Sargunjit5915/Drone-CM5-Carrier/Circular_RPi5.kicad_pcb

## KiCad design Circular_RPi5.kicad_pcb (2026-08-14)

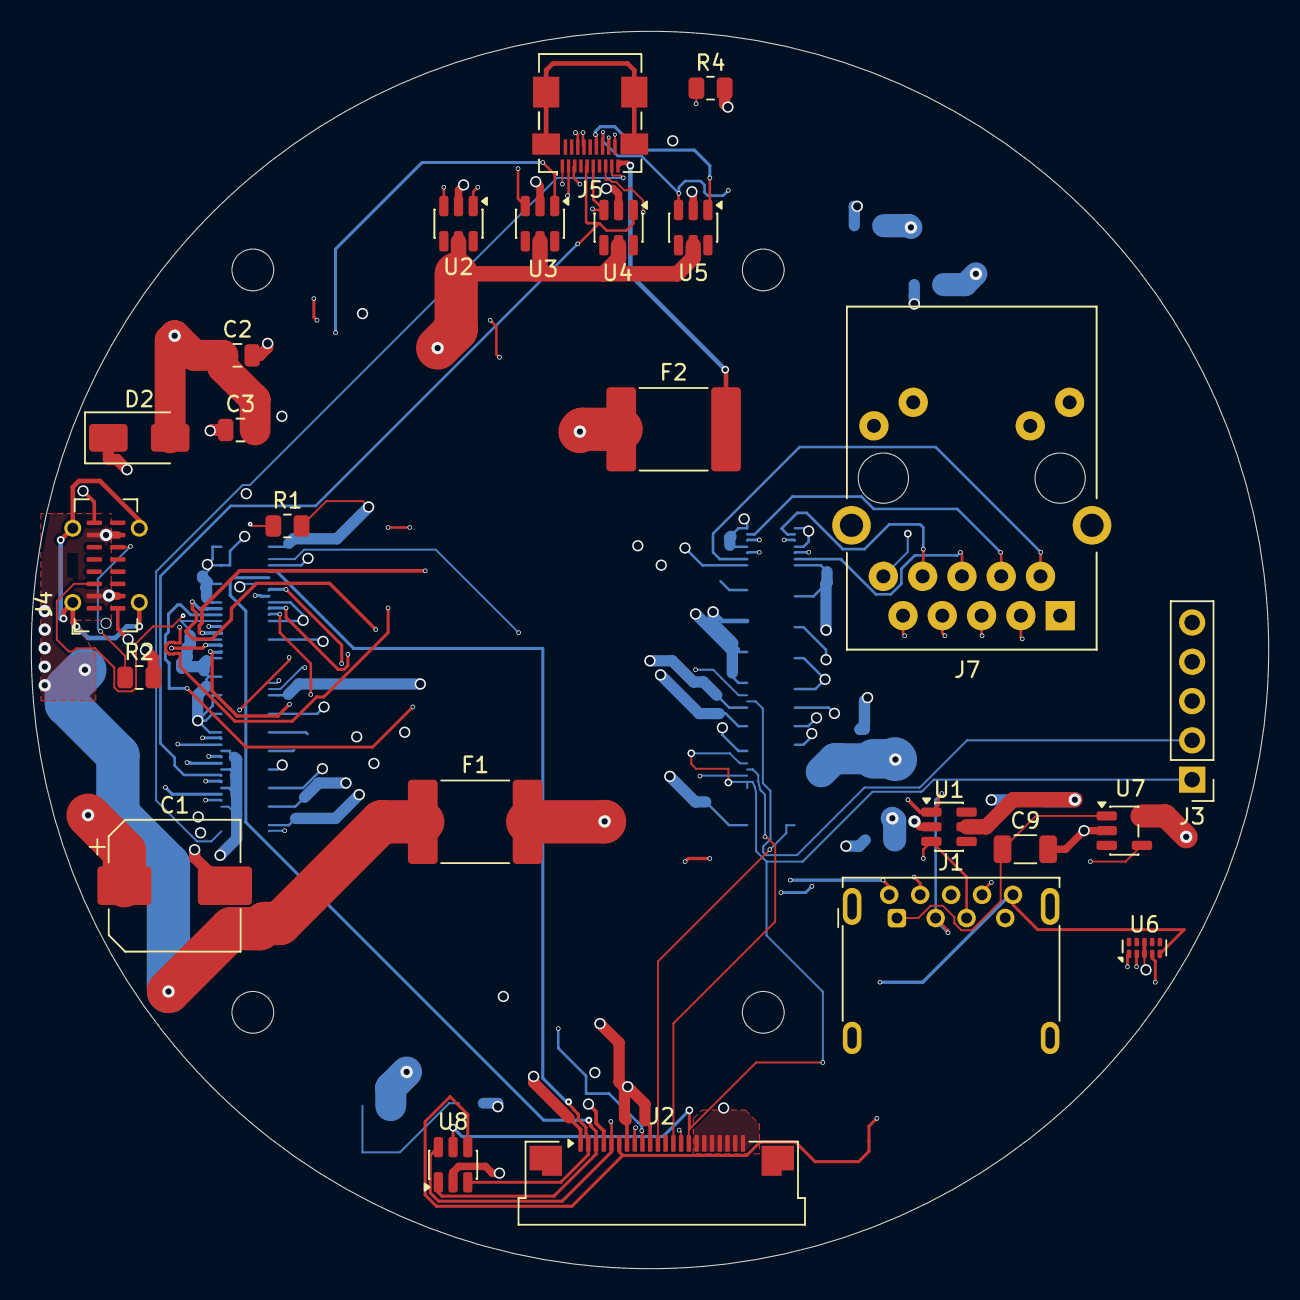
[picture p1: board Circular_RPi5.kicad_pcb from above]

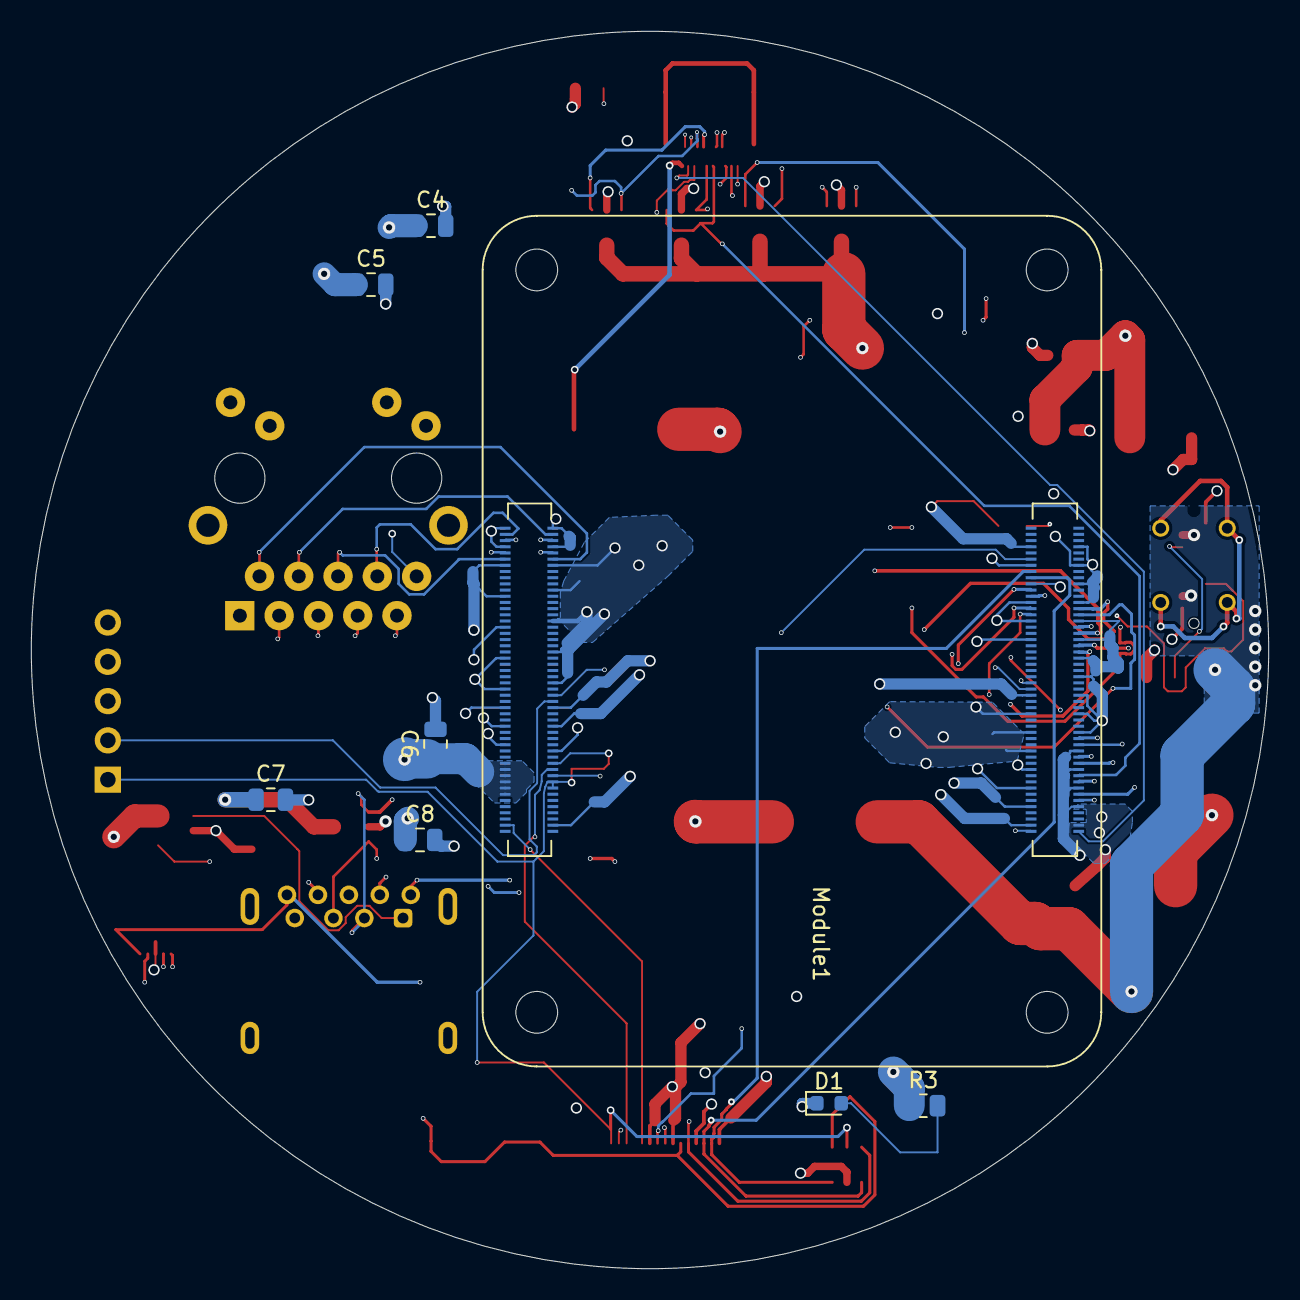
[picture p2: board Circular_RPi5.kicad_pcb from below]

Board: 6 copper layers, 80.0 x 80.0 mm, 32 parts (8 on the bottom side), 47 nets.

Parts:
C1: 470uF; CP_Elec_8x10
C2: 10uF; C_0805_2012Metric
C3, C4, C5, C6, C7, C8: 0.1uF; C_0805_2012Metric
C9: 22uF; C_1206_3216Metric
D1: LED; LED_0603_1608Metric
D2: D_TVS; D_SMA
F1, F2: 2920L500/16MR; Fuse_2920_7451Metric
J1: USB3_A; USB3_A_Molex_48393-001
J2: Conn_01x22; Amphenol_F32Q-1A7x1-11022_1x22-1MP_P0.5mm_Horizontal
J3: GPIO Pins; PinHeader_1x05_P2.54mm_Vertical
J4: USB_C; USB_C_Receptacle_G-Switch_GT-USB-7051x
J5: HDMI_D_1.4; HDMI_Micro-D_Molex_46765-0xxx
J7: RJ45_RB1-125B8G1A; RJ45_UDE_RB1-125B8G1A
Module1: ComputeModule5-CM5; Raspberry-Pi-5-Compute-Module
R1, R2: 5.1k; R_0805_2012Metric
R3: 330 ohm; R_0805_2012Metric
R4: 47k ohm; R_0805_2012Metric
U1, U2, U3, U4, U5, U8: USBLC; SOT-23-6
U6: TPD; USON-10_2.5x1.0mm_P0.5mm
U7: TPS; SOT-23-5

Connections:
+5V: C1.1, C2.1, C3.2, C4.1, C5.1, C6.1, C7.1, C8.1, D2.2 (A2), F1.2, F2.1, J3.5, Module1.77 (+5v_(Input)), Module1.79 (+5v_(Input)), Module1.81 (+5v_(Input)), Module1.83 (+5v_(Input)), Module1.85 (+5v_(Input)), Module1.87 (+5v_(Input)), R3.1, U1.5 (VBUS), U2.5 (VBUS), U3.5 (VBUS), U4.5 (VBUS), U5.5 (VBUS), U7.5 (IN)
/+3.3V: J2.15, J3.1, Module1.78 (GPIO_VREF(1.8v/3.3v_Input)), Module1.84 (+3.3v_(Output)), Module1.86 (+3.3v_(Output)), U8.5 (VBUS)
/CAM_GPIO0: J2.11, Module1.97 (CAM_GPIO0)
/Ethernet_Pair0_N: J7.R3, Module1.10 (Ethernet_Pair0_N)
/Ethernet_Pair0_P: J7.R2, Module1.12 (Ethernet_Pair0_P)
/Ethernet_Pair1_N: J7.R5, Module1.6 (Ethernet_Pair1_N)
/Ethernet_Pair1_P: J7.R4, Module1.4 (Ethernet_Pair1_P)
/Ethernet_Pair2_N: J7.R7, Module1.9 (Ethernet_Pair2_N)
/Ethernet_Pair2_P: J7.R6, Module1.11 (Ethernet_Pair2_P)
/Ethernet_Pair3_N: J7.R9, Module1.5 (Ethernet_Pair3_N)
/Ethernet_Pair3_P: J7.R8, Module1.3 (Ethernet_Pair3_P)
/GPIO2: J3.2, Module1.58 (GPIO2)
/GPIO3: J3.3, Module1.56 (GPIO3)
/HDMI0_CEC: J5.15 (CEC), Module1.151 (HDMI0_CEC)
/HDMI0_CLK_N: J5.14 (CK-), Module1.190 (HDMI0_CLK_N), U5.3 (I/O2)
/HDMI0_CLK_P: J5.12 (CK+), Module1.188 (HDMI0_CLK_P), U5.1 (I/O1)
/HDMI0_HOTPLUG: J5.1 (HPD/HEAC-), Module1.153 (HDMI0_HOTPLUG), R4.1
/HDMI0_SCL: J5.17 (SCL), Module1.200 (HDMI0_SCL)
/HDMI0_SDA: J5.18 (SDA), Module1.199 (HDMI0_SDA)
/HDMI0_TX0_N: J5.11 (D0-), Module1.184 (HDMI0_TX0_N), U4.3 (I/O2)
/HDMI0_TX0_P: J5.9 (D0+), Module1.182 (HDMI0_TX0_P), U4.1 (I/O1)
/HDMI0_TX1_N: J5.8 (D1-), Module1.178 (HDMI0_TX1_N), U3.3 (I/O2)
/HDMI0_TX1_P: J5.6 (D1+), Module1.176 (HDMI0_TX1_P), U3.1 (I/O1)
/HDMI0_TX2_N: J5.5 (D2-), Module1.172 (HDMI0_TX2_N), U2.3 (I/O2)
/HDMI0_TX2_P: J5.3 (D2+), Module1.170 (HDMI0_TX2_P), U2.1 (I/O1)
/MIPI0_C_N: J2.8, Module1.127 (MIPI0_C_N)
/MIPI0_C_P: J2.9, Module1.129 (MIPI0_C_P)
/MIPI0_D0_N: J2.2, Module1.115 (MIPI0_D0_N), U8.3 (I/O2)
/MIPI0_D0_P: J2.3, Module1.117 (MIPI0_D0_P), U8.1 (I/O1)
/MIPI0_D1_N: J2.5, Module1.121 (MIPI0_D1_N), U8.6 (I/O4)
/MIPI0_D1_P: J2.6, Module1.123 (MIPI0_D1_P), U8.4 (I/O3)
/SCL0: J2.13, Module1.80 (SCL0)
/SDA0: J2.14, Module1.82 (SDA0)
/SSRX+: J1.6, Module1.130 (USB3-0-RX_P), U6.4 (D2+)
/SSRX-: J1.5, Module1.128 (USB3-0-RX_N), U6.5 (D2-)
/SSTX+: J1.9, Module1.142 (USB3-0-TX_P), U6.1 (D1+)
/SSTX-: J1.8, Module1.140 (USB3-0-TX_N), U6.2 (D1-)
/USB3-0-D_N: J1.2, Module1.136 (USB3-0-D_N), U1.1 (I/O1)
/USB3-0-D_P: J1.3, Module1.134 (USB3-0-D_P), U1.3 (I/O2)
/VBUS_EN: Module1.111 (VBUS_EN), U7.4 (EN)
/VBUS_IN: F1.1, J4.A4, J4.A9 (VBUS), J4.B4, J4.B9 (VBUS)
GND: C1.2, C2.2, C3.1, C4.2, C5.2, C6.2, C7.2, C8.2, C9.2, D1.1 (K), D2.1 (A1), J1.4, J1.7, J1.10, J2.1, J2.4, J2.7, J2.10, J2.16, J2.17, J2.18, J2.19, J2.20, J2.21, J2.22, J3.4, J4.A12 (GND), J4.B12 (GND), J5.16 (GND), J7.R10, J7.SH, Module1.1 (GND), Module1.2 (GND), Module1.7 (GND), Module1.8 (GND), Module1.13 (GND), Module1.14 (GND), Module1.22 (GND), Module1.23 (GND), Module1.32 (GND), Module1.33 (GND), Module1.42 (GND), Module1.43 (GND), Module1.52 (GND), Module1.53 (GND), Module1.59 (GND), Module1.60 (GND), Module1.65 (GND), Module1.66 (GND), Module1.71 (GND), Module1.74 (GND), Module1.98 (GND), Module1.107 (GND), Module1.108 (GND), Module1.113 (GND), Module1.114 (GND), Module1.119 (GND), Module1.120 (GND), Module1.125 (GND), Module1.126 (GND), Module1.131 (GND), Module1.132 (GND), Module1.137 (GND), Module1.138 (GND), Module1.144 (GND), Module1.150 (GND), Module1.155 (GND), Module1.156 (GND), Module1.161 (GND), Module1.162 (GND), Module1.167 (GND), Module1.168 (GND), Module1.173 (GND), Module1.174 (GND), Module1.179 (GND), Module1.180 (GND), Module1.185 (GND), Module1.186 (GND), Module1.191 (GND), Module1.192 (GND), Module1.197 (GND), Module1.198 (GND), R1.2, R2.2, R4.2, U1.2 (GND), U2.2 (GND), U3.2 (GND), U4.2 (GND), U5.2 (GND), U6.3 (GND), U6.8 (GND), U7.2 (GND), U8.2 (GND)
unnamed: D1.2 (A), R3.2
unnamed: C9.1, J1.1, U7.1 (OUT)
unnamed: J4.A5 (CC1), R1.1
unnamed: J4.B5 (CC2), R2.1
unnamed: F2.2, J5.19 (+5V)
