Sargunjit5915/Drone-CM5-Carrier/(commit log)

2026-02-18 Initial stable 8-layer design - DRC Clean
    [Circular_RPi5.kicad_pcb, Circular_RPi5.kicad_sch]
2026-02-18 LED fixed
    [Circular_RPi5.kicad_pcb, Circular_RPi5.kicad_sch]
2026-02-23 PCB Fixed
    [Circular_RPi5.kicad_pcb, Circular_RPi5.kicad_sch]
2026-02-23 Reduced to 6 layers
    [Circular_RPi5.kicad_pcb]
2026-08-13 Fix CM5 carrier board pre-fab issues: GPIO_VREF, USB3 D+/D-, MIPI ESD, Gigabit Ethernet, fuse rating
    Schematic:
    - Wire GPIO_VREF (CM5 pin 78) to +3.3V; the module datasheet requires this
    tied to CM5_3.3V or CM5_1.8V or the GPIO bank is unreferenced.
    - Rewire J1's USB3 D+/D- from CM5 pins 105/103 (an unrelated standalone USB2
    port) to pins 134/136 (USB3-0-DP/DM), the correct companion pins for the
    SuperSpeed TX/RX lines already wired to that port.
    - Fix U8 (USBLC6-4SC6) label typos: MIPI_D0/D1_* -> MIPI0_D0/D1_* and
    +3,3V -> +3.3V. U8 was sitting electrically isolated on orphan nets and
    provided no ESD protection on the MIPI0 camera lines.
    - Replace J7 (Amphenol RJMG1BD3B8K1ANR, con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
    [Circular_RPi5.kicad_pcb, Circular_RPi5.kicad_sch]
2026-08-13 Complete routing: board is fully routed and DRC clean, ready for final review
    All 22 previously-unrouted nets are now connected (manual GUI routing by
    Sargunjit): GPIO_VREF, USB3-0 D+/D-, all four Gigabit Ethernet differential
    pairs to J7, the U8 MIPI0 ESD splice, and the relocated F1/F2/R1 power paths.
    DRC now reports 0 errors and 0 unconnected pads.
    Changes in this commit:
    - Resolve the /SSTX+ vs J7 SH pad clearance violation via interactive
    differential-pair routing (the scripted point-nudge approaches attempted
    earlier could not clear it without trading it for a new violation).
    - Remove three dangling copper artifacts left over from the F1/F2/R1
    relocation: a 0.055mm /USB3-0-D_N r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
    [Circular_RPi5.kicad_pcb]
2026-08-14 Rebuild J4 5V power entry as copper zones; scope custom DRC rules correctly
    DRC IS NOT CLEAN after this commit -- 201 violations remain and they are real.
    See the breakdown at the end of this message. This commit is an improvement to
    the J4 power entry, not a release gate.
    J4 VBUS_IN power entry rebuilt:
    - Deleted 19.2mm of 0.25mm-wide VBUS_IN track snaking around J4. On 1oz outer
    copper that carries ~0.88A; it was being asked to carry 5A, so it was acting
    as a fuse. The pre-existing 2.8mm trunk out to F1 was left intact.
    - Added two VBUS_IN copper zones: F.Cu 26.25 mm2 (left pocket plus a corridor
    north to the existing trunk via at 105.2,97.8) and B.Cu 58.68 mm2 (under the
    connecto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
    [Circular_RPi5.kicad_pcb, Circular_RPi5.kicad_sch]
2026-08-14 Widen high-speed pair traces to the maximum their local clearance allows
    DRC 201 -> 111 violations, with zero new clearance violations and 0 unconnected.
    Widened 167 outer-layer segments on the HS_100 and HS_90_USB3 nets. 126 of 182
    candidates reached their full rule target (107 to 0.17mm, 19 to 0.19mm); the
    remaining 56 are hemmed in by neighbouring copper and were taken only as far as
    their local space permits (0.128-0.153mm).
    Method: a blanket widen to 0.17/0.19mm was tried first and rejected -- it cleared
    146 width violations but introduced 61 new clearance ones (15 intra-pair plus 47
    genuine collisions against GND vias, GND pads, and other nets at 0.097-0.123mm
    against a 0.127mm rule)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
    [Circular_RPi5.kicad_pcb]
2026-08-14 Scope the 5A width rule to the real high-current path; DRC now clean
    DRC: 39 violations -> 1 (the harmless "CM5IO library not configured locally"
    note). 0 unconnected pads, 0 footprint errors.
    Root cause: the 2.5mm minimum was applied to the whole +5V net, but +5V
    distribution on this board is plane-based -- a 4614 mm2 pour on In3.Cu with 12
    0.8mm/0.4mm stitching vias. Almost all +5V surface copper is therefore a short
    local branch, not a current path. Tracing all 37 flagged segments to what they
    actually feed:
    15 segs @1.0mm U1..U5 ESD diode VBUS pins leakage, microamps
    ~13 segs C2..C8 decoupling stubs AC only, no DC path
    1 seg @2.0mm D2 TVS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
    [Circular_RPi5.kicad_pcb]
2026-08-14 Final layout: DRC clean, J1 placed on-board, cleared for prototype fabrication
    Sargunjit's interactive routing pass clears the remaining width violations and
    places J1 (USB3 Type-A) fully inside the board outline.
    Verification for this state:
    - DRC: 1 violation, and it is the "CM5IO footprint library not configured"
    note -- a local KiCad library-table issue on this machine, not a board defect.
    - 0 unconnected pads. 0 DRC exclusions. No safety-critical rule downgraded to
    warning or ignore (clearance, shorting_items, copper_edge_clearance,
    hole_clearance, unconnected_items, track_width, solder_mask_bridge all error).
    - 0 vias inside SMD pads. 0 pads outside or within 0.2mm of the board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
    [Circular_RPi5.kicad_pcb]
